DrCosha/MHI-AC-Ctrl/SW-Configuration.md

# Introduction
The following descriptions address:
1. Basic settings for your configuration
2. Advanced settings for other frameworks (e.g. Tasmota, Home Assistant, Homie)
3. Integration examples

# Changes in fork (Изменения в ветке)
Конфигурация вынесена в отдельный файл ***local.h***. Туда вынесены все локальные пароли и адреса.  Достаточно закомментировать строку
#include "local.h" в файле [support.h](src/support.h) и после этого компилятор будет использовать внутренние объявления в коде. Описание которых приведено ниже.

The configuration is placed in a separate file ***local.h***. All local passwords and addresses are listed there. It is enough to comment 
out the line #include "local.h" in the [support.h](src/support.h) file and after that the compiler will use internal declarations in the code. The description of which is given below.

# Basic settings
The basic settings will be adapted in three files:   
 - [support.h](src/support.h) for general settings related to WiFi, MQTT, OTA and the external temperature sensor DS18x20
 - [MHI-AC-Ctrl.h](src/MHI-AC-Ctrl.h) for input / output settings (i.e. topic / payload text)
 - [MHI-AC-Ctrl-core.h](src/MHI-AC-Ctrl-core.h) for settings related to the behaviour of MHI-AC-Ctrl (e.g. selection of operating data)

## WiFi ([support.h](src/support.h))
WiFi STA mode is supported.

### WiFi Settings (SSID, Password, hostname)
Adapt the SSID and the password. Changing the hostname is usually not required.
```
#define WIFI_SSID "your SSID"
#define WIFI_PASSWORD "your WiFi password"
#define HOSTNAME "MHI-AC-Ctrl"
```
 Changing the hostname is required when multiple ACs should be supported. E.g. replace "MHI-AC-Ctrl" by "Living-Room-MHI-AC-Ctrl"

Per default ESP8266 uses the first WiFi access point (AP) with matching SSID. This behaviour can be changed.
```
#define UseStrongestAP true             // when false then the first WiFi access point with matching SSID found is used.
                                        // when true then the strongest WiFi access point with matching SSID found is used, it doesn't work with hidden SSID
```
Configure the time interval for searching a stronger AP.
```
#define WiFI_SEARCH_FOR_STRONGER_AP_INTERVALL 12    // WiFi network re-scan interval in minutes with alternate to +5dB stronger signal if detected
```
 
## MQTT ([support.h](src/support.h))
The program uses the [MQTT client library](https://github.com/knolleary/pubsubclient) from Nick O'Leary (knolleary).
If you are not familiar with MQTT you find on the Internet endless numbers of descriptions and tutorials. My favorites are [here](https://www.hivemq.com/blog/how-to-get-started-with-mqtt/) and [here](https://www.heise.de/developer/artikel/Kommunikation-ueber-MQTT-3238975.html).
I recommend [MQTT Explorer](http://mqtt-explorer.com/) a great all-round MQTT client that provides a structured topic overview for the first steps.

### MQTT General Settings (broker, port, account data)
Adapt the server (broker) name and the port if needed:

```
#define MQTT_SERVER "MQTT broker name"  // broker name or IP address of the broker
#define MQTT_PORT 1883                  // port number used by the broker
```

If you want to use MQTT authentication enter user name and password:
```
#define MQTT_USER ""          // if authentication is not used, leave it empty
#define MQTT_PASSWORD ""      // if authentication is not used, leave it empty
```
note: TLS/SSL is not supported

The following sections show the configuration for the MQTT pathes.
### MQTT status
The topic level for status information from the AC consists of the MQTT_PREFIX and the function name separated by a slash, e.g. *MHI-AC-Ctrl/Power*.   
For writes the topic level consists of the MQTT_PREFIX, the prefix for set commands (MQTT_SET_PREFIX) and the function name, each separated by a slash, e.g. *MHI-AC-Ctrl/set/Power*.  
You can change MQTT_PREFIX and MQTT_SET_PREFIX, default is
```
#define MQTT_PREFIX HOSTNAME "/"           // basic prefix used for publishing AC data
#define MQTT_SET_PREFIX MQTT_PREFIX "set/" // prefix for subscribing set commands
```
Please pay attention to the case sensitivity.

The following status data is available (prefix is not listed)
They are only published when there is a change of the message. The retained flag is 'true'.
When writing data, the retain flag shall be 'false'!

topic|r/w|value|comment
-----|---|-----|------
Power|r/w|"On", "Off"|
Mode|r/w|"Auto", "Dry", "Cool", "Fan", "Heat" and "Off"|"Off" is only supported when option [POWERON_WHEN_CHANGING_MODE](#behaviour-when-changing-ac-mode-supporth) is selected
Tsetpoint|r/w|18 ... 30|Target room temperature (float) in °C, resolution is 0.5°C
Fan|r/w|1,2,3,4,"Auto"|Fan level
Vanes|r/w|1,2,3,4,"Swing","?"|Vanes up/down position <sup>1</sup>
Troom|r/w|0 ... 35|Room temperature (float) in °C, resolution is 0.25°C  <sup>2</sup>
Tds1820|r|-40 .. 85|Temperature (float) by the additional DS18x20 sensor in °C, resolution is 0.5°C  <sup>3</sup>
Errorcode|r|0 .. 255|error code (unsigned int)
ErrOpData|w||triggers the reading of last error operating data

<sup>1</sup> When the last command was received via the infrared remote control then the Vanes status is unknown and the "?" is published.   
<sup>2</sup> Please compare with section [Room temperature](#room-temperature) for writing.   
<sup>3</sup> Only available when a DS18x20 is connected, please see the description in [Hardware.md](Hardware.md) and in section [External Temperature Sensor Settings](#external-temperature-sensor-settings-supporth).

Additionally, the following program status topics are available:

topic    |r/w| value |comment
---------|---|---|---
cmd_received|r|"o.k.", "unknown command" or "invalid parameter"|feedback for last set command
connected|r  |0, 1|MQTT connection status to broker
fMISO    |r  |unsigned integer|frequency of the MISO pin in Hz during boot
fMOSI    |r  |unsigned integer|frequency of the MOSI pin in Hz during boot
fSCK     |r  |unsigned integer|frequency of the SCK pin in Hz during boot
reset|w|"reset"|resets the ESP8266
RSSI     |r  |integer         |WiFI RSSI / signal Strength in dBm after MQTT (re-)connect
Version  |r  |string          |Version number of MHI-AC-Ctrl
WIFI_LOST|r  |integer         |number of lost WiFi connections since last reset
MQTT_LOST|r  |integer         |number of lost MQTT connections since last reset
APs      |r  |string          |Matched APs seen at scan with RSSI value

note: The topic and the payload text of the status data is adaptable by defines in [MHI-AC-Ctrl.h](src/MHI-AC-Ctrl.h)

### MQTT operating data
MHI-AC-Ctrl can provide operating data of the indoor and outdoor unit. This data is not needed for daily use, but might be interesting in specific use cases. Operating data is only published when there is a change of the content. The retained flag is 'true'.
The path to the operating data topic can be adapted.

```
#define MQTT_OP_PREFIX "OpData/"    // prefix for publishing operating data
```

Without changes of the path, subscribe to *MHI-AC-Ctrl/OpData/#* for receiving all operating data. Please see section [Operating data](#operating-data-mhi-ac-ctrl-coreh) to find all supported operating data.

note: The topic and the payload text is adaptable by defines in [MHI-AC-Ctrl.h](src/MHI-AC-Ctrl.h)

### MQTT last error operating data
When an error in the AC occurs, some operating data of this error are stored in the AC and can be read out.
The path to the operating data topic is defined in   
```
#define MQTT_OP_PREFIX "ErrOpData/"    // prefix for publishing operating data from last error
```
The readout of last error operating data is triggered by publishing *ErrOpData* to topic ErrOpData. Not all of the operating data from section [Operating data](#operating-data-mhi-ac-ctrl-coreh) might be available as last error operating data.

note: The topic and the payload text is adaptable by defines in [MHI-AC-Ctrl.h](src/MHI-AC-Ctrl.h)

## OTA Settings ([support.h](src/support.h))
OTA (Over the Air) update is the process of loading the firmware to ESP module using Wi-Fi connection rather than a serial port.
The OTA hostname can be adapted, per default it is the hostname used by WiFi.
```
#define OTA_HOSTNAME HOSTNAME     // default for the OTA_HOSTNAME is the HOSTNAME
#define OTA_PASSWORD ""           // Enter an OTA password if required
```
## External Temperature Sensor Settings ([support.h](src/support.h))
When an external temperature sensor is connected, you can configure the pin where DQ of the the DS18x20 is connected, default is Pin 4 (D2)
and how often the sensor should be read. To use reading of the external sensor you must adapt the TEMP_MEASURE_PERIOD.

```
#define TEMP_MEASURE_PERIOD 0   // period in seconds for temperature measurement with the external DS18x20 temperature sensor
                                // set to e.g. 30 to read the sensor every 30 seconds. 
#define ONE_WIRE_BUS 4          // D2, PIN for connecting temperature sensor DS18x20 DQ pin
#define ROOM_TEMP_DS18X20_OFFSET 0.0   // Temperature offset for DS18x20 sensor, can be positive or negative (examples: 0.0, -1.0, 1.5)

```
note: The according libraries [OneWire](https://www.pjrc.com/teensy/td_libs_OneWire.html) and [DallasTemperature](https://github.com/milesburton/Arduino-Temperature-Control-Library) are only used if TEMP_MEASURE_PERIOD > 0.

If the DS18x20 should replace the room temperature sensor of the AC, you have to configure it as described in the next clause.

## Room temperature
Usage of the room temperature sensor inside the AC is the default, but instead you can use the DS18x20 sensor on the MHI-AC-Ctrl board or the received temperature via the MQTT topic Troom. Setting Troom via MQTT works per default. But you should adapt ROOM_TEMP_MQTT_TIMEOUT. For using DS18x20 as Troom you have to use ROOM_TEMP_DS18X20.
```
//#define ROOM_TEMP_DS18X20           // use room temperature from DS18x20

#define ROOM_TEMP_MQTT_TIMEOUT  40    // time in seconds, after this time w/o receiving a valid room temperature
                                      // via MQTT fallback to IU temperature sensor value
#define TROOM_FILTER_LIMIT 0.25       // Defines from which Troom delta value a new Troom value is published. Resolution 0.25°C.
                                      // With a smaller resolution, Troom could toggle more. To deactivate the filter use 0.

```
ROOM_TEMP_MQTT_TIMEOUT must be greater than the period of room temperature update via MQTT. E.g. when the room temperature update via MQTT is done every minute, then ROOM_TEMP_MQTT_TIMEOUT could be 2 minutes.
If the timeout occurs, and the system falls back to IU temperature, it will return to using the MQTT room temperature if the MQTT messages resume.

## Enhance resolution of Tsetpoint ([support.h](src/support.h))
The AC is only accepting a setpoint in x.0 degrees. If you send x.5 degrees, the AC will convert this to (x+1).0 degrees. So using .5 degrees as a setpoint will increase the setpoint on the AC not with .5 degrees but with 1 degree. This behaviour can be changed with: 
```
#define ENHANCED_RESOLUTION true                    // when using Tsetpoint with x.5 degrees, airco will use (x+1).0 setpoint
                                                    // uncomment this to compensate (offset) Troom for this.
                                                    // this will simulate .x degrees resolution
```
If you now send x.5 degrees as setpoint, still the setpoint on the AC will be (x+1). But when sending the received Troom (from MQTT or the external temperature sensor) to the AC, Troom with an offset of .5 degrees will be send to the AC. This way the AC will increase the temperature in the room with .5 degrees instead of 1 degree.

The MQTT topic Troom will show (like before) the Troom received by the AC (including the offset).

For example: when setpoint is 20.5. When Troom 19.5 is received (from MQTT or DS18x20), Troom sent to the AC will be 20.0. Topic Troom will also show 20.0.

## Behaviour when changing AC mode ([support.h](src/support.h))
Per default the power on/off state is not changed, when you change the AC mode (e.g. heat, dry, cold etc.).
But when you uncomment the following line, then the AC is switched on, once you change the AC mode and switched off if you publish "Off" to Mode (instead of Power). This beahviour is requested for use with [Home Assistant](https://www.home-assistant.io/).
```
//#define POWERON_WHEN_CHANGING_MODE true           // uncomment it to switch on the AC when the mode (heat, cool, dry etc.) is changed
```

# Advanced settings

## Topic and payload text ([MHI-AC-Ctrl.h](src/MHI-AC-Ctrl.h))
All topic and payload text is included in defines, e.g. change
```
#define PAYLOAD_POWER_ON "On"
```
to
```
#define PAYLOAD_POWER_ON "on"
```
if your framework prefers lower case. These topics and payloads are used for MQTT topics and payloads.

## Operating data ([MHI-AC-Ctrl-core.h](src/MHI-AC-Ctrl-core.h))
Currently the following operating data in double quotes are supported
```
  { 0xc0, 0x02},  //  1 "MODE"
  { 0xc0, 0x05},  //  2 "SET-TEMP" [°C]
  { 0xc0, 0x80},  //  3 "RETURN-AIR" [°C]
  { 0xc0, 0x81},  //  5 "THI-R1" [°C]
  { 0x40, 0x81},  //  6 "THI-R2" [°C]
  { 0xc0, 0x87},  //  7 "THI-R3" [°C]
  { 0xc0, 0x1f},  //  8 "IU-FANSPEED"
  { 0xc0, 0x1e},  // 12 "TOTAL-IU-RUN" [h]
  { 0x40, 0x80},  // 21 "OUTDOOR" [°C]
  { 0x40, 0x82},  // 22 "THO-R1" [°C]
  { 0x40, 0x11},  // 24 "COMP" [Hz]
  { 0x40, 0x85},  // 27 "TD" [°C]
  { 0x40, 0x90},  // 29 "CT" [A]
  { 0x40, 0xb1},  // 32 "TDSH" [°C]
  { 0x40, 0x7c},  // 33 "PROTECTION-No"
  { 0x40, 0x1f},  // 34 "OU-FANSPEED"
  { 0x40, 0x0c},  // 36 "DEFROST"
  { 0x40, 0x1e},  // 37 "TOTAL-COMP-RUN" [h]
  { 0x40, 0x13},  // 38 "OU-EEV" [Puls]
  { 0xc0, 0x94},  //    "energy-used" [kWh]
```

note1: If you are not interested in these operating modes (e.g. to reduce the MQTT load) you can comment out the according lines. But at least 1 line has to stay.
For THI-R2, THO-R1 and TDSH the formula for calculation is not yet known.
You can find some hints related to the meaning of the operating data [here](https://www.hrponline.co.uk/media/pdf/41/42/ed/Beijer-Ref-Service-Support-Handbook-19cWKESQUhzVIy5.pdf#page=7). Addtional opdata information is available [here](https://github.com/absalom-muc/MHI-AC-Trace/blob/main/SPI.md#operation-data-details).  

note2: The energy-used is the energy in kWh counting from power on the AC. If you power off the AC, the value (in kWh) will keep the last value. When you power on the AC again, it will start from 0 again.

hint: The error operating data is usually a sub-set of the operating data above. If user requests error operating data, all available error operating data is provided independent from the list above.

## Access Speed ([MHI-AC-Ctrl-core.h](src/MHI-AC-Ctrl-core.h ))
Default the above operating data is requested within 400 frames. Because 20 frames takes 1 second, the update interval for all operating data will be  400/20 = 20 seconds. If you disable some operating data (above), the update interval will stay 20 seconds.
With the following parameter you can change this interval of 20 seconds.
```
#define NoFramesPerOpDataCycle 400             // number of frames used for a OpData request cycle; will be 20s (20 frames are 1s)
```
Some operating data (32 -38) will take some time at the AC for processing. So don't decrease this value too much.

Changes to Power, Mode, Tsetpoint, Fan and Vanes wll be written to the AC right away. Above parameter will not influence this.

## Jitter internal temperature sensor ([MHI-AC-Ctrl-core.h](src/MHI-AC-Ctrl-core.h ))
If the AC internal temperature sensor is used, the received Troom can changes (+/- 0.25 degrees) sometimes several times in a second. This will give a burst of MQTT Troom messages.
To avoid this behaviour, the changed received Troom will only be published after at least 5 seconds. This is ONLY the case when the AC internal temperature sensor is used.
With the following parameter you can change this minimum interval of 5 seconds.
```
#define minTimeInternalTroom 5000              // minimal time in ms used for Troom internal sensor changes for publishing to avoid jitter 
```

This jitter can also be avoided by using the TROOM_FILTER_LIMIT as descibed above. But this filter is also used if the temperature is provided by an external temperature sensor or a connected DS18B20. With above it will be also possible to see smaller changes.

## Not switching off AC when MQTT connections fails ([MHI-AC-Ctrl.h](src/MHI-AC-Ctrl.h))
Default the module stops communicating with the AC when the MQTT connection get disconnected. After 120 sec the AC will power off because of [this](https://github.com/absalom-muc/MHI-AC-Ctrl/blob/master/Troubleshooting.md#fire-ac-switches-power-off-sometimes).
When using a DS18x20 as room temperature sensor, this can be unwanted behaviour. Also at night or when not at home when this happens, can be unwanted behaviour. 
This behaviour can be changed by changing the following line:
```
//#define CONTINUE_WITHOUT_MQTT true
```
to
```
#define CONTINUE_WITHOUT_MQTT true
```

Warning: be aware that there might be some safety implication and that the deactivation of this feature is on your own risk.
The AC now keeps running and no control is possible anymore when MQTT is disconnected. Also of course no MQTT topics are updated anymore. Of course control is still possible with the remote control.

## MHI-AC-Ctrl partitioning
MHI-AC-Ctrl-core implements the core functions (SPI read/write, communication with the wrapper).
Wifi, MQTT, OTA and DS18x20 stuff is located in support.h and support.cpp.
MHI-AC-Ctrl.ino and MHI-AC-Ctrl.h contain the wrapper for MHI-AC-Ctrl-core.cpp and support.cpp.

### MHI-AC-Ctrl-core.h and MHI-AC-Ctrl-core.cpp
Usually it should be not touched, only configured via [MHI-AC-Ctrl-core.h](src/MHI-AC-Ctrl-core.h).
AC status information change will trigger the callback function cbiStatusFunction located in [MHI-AC-Ctrl.ino](src/MHI-AC-Ctrl.ino)
It is controlled via the functions:
```
void init();                          // initialization called once after boot
void reset_old_values();              // resets the 'old' variables ensuring that all status information are resend
int loop(uint max_time_ms);           // receive / transmit a frame of 20 bytes
void set_power(boolean power);        // power on/off the AC
void set_mode(ACMode mode);           // change AC mode (e.g. heat, dry, cool etc.)
void set_tsetpoint(uint tsetpoint);   // set the target temperature of the AC)
void set_fan(uint fan);               // set the requested fan speed
void set_vanes(uint vanes);           // set the vanes horizontal position (or swing)
void set_troom(byte temperature);     // set the room temperature used by AC
void request_ErrOpData();             // request that the AC provides the error data
```
The following sections describe the usage of these functions.

#### void init()
Configures the input /output state of the SPI pins. Resets old values.

### reset_old_values()
This should be called if you want to ensure that the receiver of the status data has the latest data. E.g. in case of a MQTT broker disconnect it should be called.

### int loop(uint max_time_ms)
For receiving / transmitting a frame of 20 bytes.
The input parameter is the maximum time which should be consumed by the loop function. Use a value > T<sub>Frame</sub> + T<sub>FramePause</sub> to ensure there is sufficient time to receive a frame.

This is a blocking function which takes - dependent on the AC model - about 10 ... 50ms. Inside the loop function no delay() or yield() call is used.
The following return values are supported:

return value|meaning
------------|-------------
err_msg_valid_frame     |a valid frame was received in the given time
err_msg_invalid_signature | a frame with invalid signature bytes was received
err_msg_invalid_checksum | a frame with an invalid checksum was received
err_msg_timeout_SCK_low | the specified time max_time_ms has been exceeded because SCK is const low and not toggling
err_msg_timeout_SCK_high | the specified time max_time_ms has been exceeded because SCK is const high and not toggling

note: The input parameters and return values could be changed in future.

### set_*()
Controls the AC.

### request_ErrOpData()
The error operating data will be read upon a request via this function.

### support
Provides the interface between MHI-AC-Ctrl and the user interfaces. 
It contains helper functions for serving WiFi, MQTT, OTA and the external temperature sensor DS18x20. 

### MHI-AC-Ctrl.h and MHI-AC-Ctrl.ino
This is the wrapper for MHI-AC-Ctrl-core and support.
It provides beside the standard setup() and loop() functions the following two functions.

#### void cbiStatusFunction(ACStatus status, int value)
This is a member of the class StatusHandler : public CallbackInterface_Status. It is a callback function called by MHI-AC-Ctrl-core in case of AC status changes. 

#### void MQTT_subscribe_callback(char* topic, byte* payload, unsigned int length)
This function is called for incoming MQTT messages, the message is analyzed and translated to function calls.
From systematic point of view this function should actually be located in [support.h](src/support.h) but in order to keep it simple it resides in [MHI-AC-Ctrl.ino](src/MHI-AC-Ctrl.ino). 

# Integration examples
You find here some examples for integration of MHI-AC-Ctrl
- [Node-Red / Google Assistant](https://github.com/absalom-muc/MHI-AC-Ctrl/issues/60)
- [openHAB](https://community.openhab.org/t/control-mhi-aircon-by-mqtt/104972)
- [IoT MQTT Panel](https://github.com/absalom-muc/MHI-AC-Ctrl/issues/59)
- [Home Assistant](https://github.com/absalom-muc/MHI-AC-Ctrl/issues/58)
- [ESPHome](https://github.com/absalom-muc/MHI-AC-Ctrl/commit/4531327ff2b474eb047317975211df0430bdf199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)
- [Tasmota](https://github.com/absalom-muc/MHI-AC-Ctrl/issues/13#issuecomment-630425714)
- [ioBroker](https://forum.iobroker.net/topic/17041/anfrage-airconwithme-intesishome-klimasteuerung-adapter/14)
- [FHEM](https://forum.fhem.de/index.php/topic,88841.0/all.html)
- [WiFi SSID, hostname and MQTT server dynamic](https://github.com/absalom-muc/MHI-AC-Ctrl/pull/69)
- [Web page with MQTT](https://github.com/absalom-muc/MHI-AC-Ctrl/issues/141)
