DrCosha/MHI-AC-Ctrl/images/PCB_MHI_adapter _HW4-all_layer.png

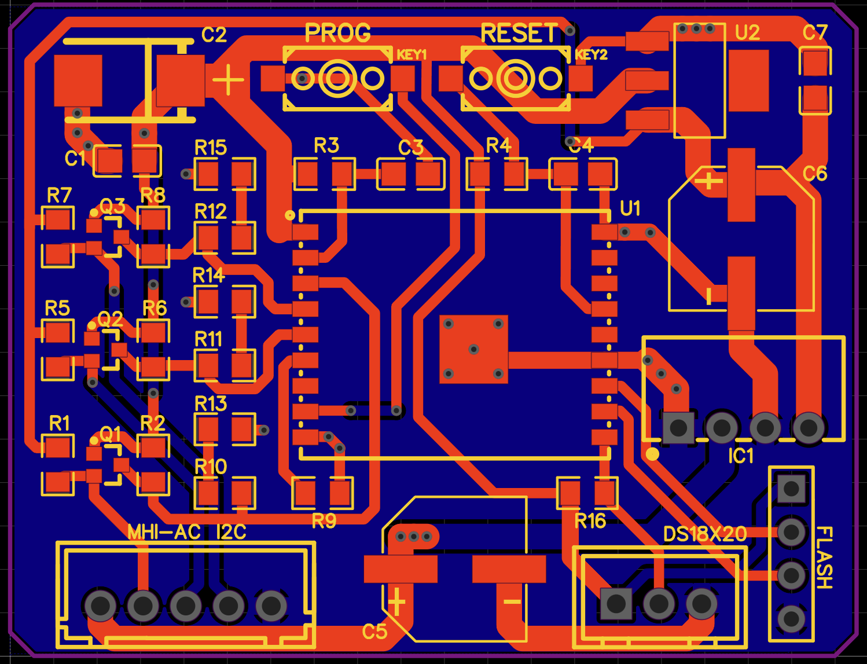
images/PCB_MHI_adapter _HW4-all_layer.png
