DrCosha/MHI-AC-Ctrl/Hardware/3D/OBJ_PCB_MHI adapter rev 3.obj

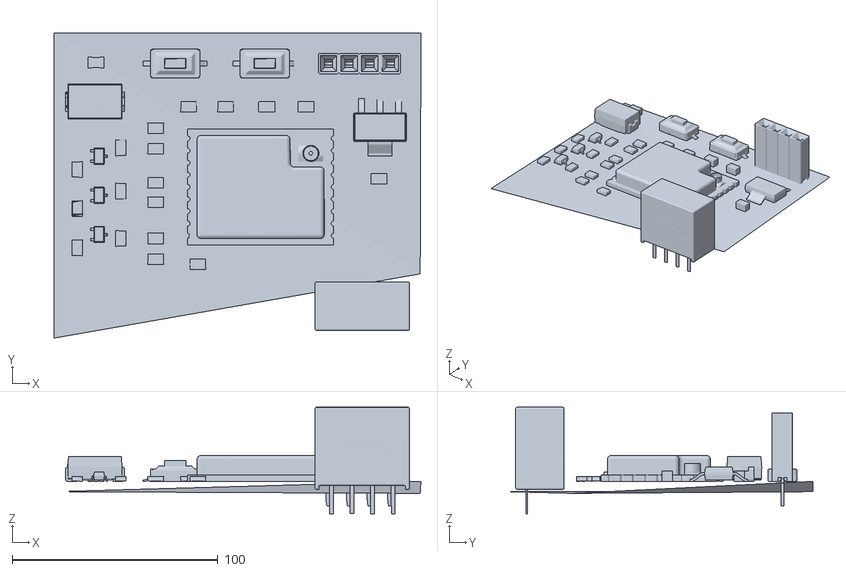
[picture p5: CAD file, 2023-11-14]
Hardware/3D/OBJ_PCB_MHI adapter rev 3.obj
178.3 x 148.3 x 51.8
