DrCosha/MHI-AC-Ctrl/(commit log)

2023-09-05 Перенос в VSC
2023-09-05 Change Arduino to VSCS
2023-11-14 Адаптация под локальную сеть и вынос секретов в отдельный файл
    [OBJ_PCB_MHI adapter rev 3.obj]
2023-11-14 Убрал warning-и при компиляции.
2023-11-14 Фикс второго модуля
2023-11-15 Поправил группу для публикации в MQTT
2023-11-16 Hardware изменения + смена базовой платы ESP c отладочной D1 на реально используемую esp_wroom_02.
2023-11-16 Наведение порядка в проекте
    [OBJ_PCB_MHI adapter rev 3.obj]
2023-11-21 Отладка на кондиционере SRK20ZS-W
2023-11-22 Change mode to POWERON_WHEN_CHANGING_MODE
2023-11-23 Отладка значений Vanes для SKR20ZS-W
2023-11-23 Отладка VANES - дубль вывода исходных данных
2023-11-23 Изменил отладку в топик на отдельный define
2023-11-23 Подключение расширенного размера фрейма
2023-11-23 Вывод в топик только при изменении
2023-11-23 Заготовка под обработку пресетов
